millerlp/MusselGapeTracker/(commit log)

2017-06-19 NON-FUNCTIONAL
    Hardware needs revision since ADC7 can't be used as an output to control
    the battery monitor circuit.
2017-06-20 Working 16-channel polling of the hall effect sensors
2017-06-21 Fixing name in comments
    [Shift_mux_test2.ino]
2017-06-21 Basic functionality - datalogging and singel-channel live update
    Currently begins auto-logging to SD card on all 16 channels. Also
    implemented a setup mode (hold button1 for 3 seconds) to show fast
    updates of a single channel. Need to implement a screen power-off and
    channel selection during normal datalogging.
2017-06-22 Added screen updates and timeout
    Still tracking down a bug that causes a hang intermittenly. Have tried
    implementing a watchdog timer (2sec) to see if that at least gets the
    reset working, but it's still not clear where the hang is coming from. The
    real time clock continues running and outputting 32.768kHz signal, so it's
    not an issue with the power supply. Button2 is currently co-opted as an
    output in this version to help with monitoring on the scope ( bitSet(PIND,
    3) peppered throughout)
    [Logger_test.ino]
2017-06-22 Added watchdog timer reset to try to bandaid fix the occasional hangups. I believe the occasional hangs were due to the I2C bus freezing, which can supposedly lock the entire AVR and require a full r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
    [Logger_test.ino]
2017-06-22 Enabling watchdog and switching to Optiboot v6.2 so that I can check the MCUSR register after a reboot to know why it rebooted. The system appears to be generating a large current draw for approx 1 s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
    [Logger_test.ino]
2017-06-23 Switching off some of the LED flashing
2017-06-23 Adding comments for correct bootloader
    [Logger_test.ino]
2017-06-25 Adding flag to declare full OLED screen redraws
    Set screenChange = true to force the OLED screen to redraw the channel
    labels, or false to only update the Hall effect values (faster).
    Interestingly, the optiboot bootloader appears to be jumping to the main
    program too fast for my home ftdi programmer, so I have to hit the reset
    button just prior to attempting a new firmware upload over serial.
    [Logger_test.ino]
2017-06-25 Implementing current filename display
    User can press Button 1 to cycle through the channels on display, and
    eventually get to a 5th screen that just shows the current file name.
2017-06-26 Testing current draw
2017-06-26 Experimenting with only taking readings on save interval
    Test case where Hall sensors are only read when the takeSamples flag is
    true and either the OLED screen is on or the writeData flag is true.
    This has introduced a symptom where the current draw is not returning to
    normal after a SD write until another round of Hall sensor readings are
    taken.
2017-06-27 Adding delay + shift register clear after writeToSD
    Was having a problem with high current draw immediately after writes to
    the SD card. It appears the shift register (which shares the SPI bus
    with the SD card) wasn't happy with whatever signals were being sent to
    the SD card and was occasionally ending up in some kind of high current
    draw state. Adding a 10ms delay and an additional clear() call to the
    shift registers after the writeToSD call appears to have removed the
    high current draw issue.
    [Logger_test.ino, MusselGapeTracker.ino]
2018-09-07 Adding boards.txt entry
2018-09-27 Changing ouptut to input Button2
    Button 2 isn't currently used for any functions, but I might as well make it a functional input for the future.
2018-10-18 Fixing RevC pin assignments
    Switched analog input from A0 to A7 to suit RevC hardware.
    [MusselGapeTracker.ino]
2018-10-25 Quick test sketch to see that ADC6 works
    Written for older RevA hardware, but should work on RevC hardware as well, if you enable the battery monitor line BATT_MONITOR_EN.
2018-10-25 Removing testing pin twiddling
2018-11-28 Checking on calibration mode, needs work
    Need to update and include calibration output here, chase down why analog data isn't showing up on screen
2019-04-30 Fixed calibration mode readout
    Needed to enable the multiplexer in the calibration mode in order to show the Hall sensor readout for the single channel.
    [MusselGapeTracker.ino]
2019-04-30 Built two more boards
2019-05-01 Working routine, needs refinement
    Functional prototype, can be used to choose 1 of 16 Hall effect channels and write calibration data to SD card. Could use some refinement on the OLED screen display.
2019-05-02 Revising instructions, OLED updates
    Functional program now, can be used to calibrate Hall effect sensors.
2019-05-03 Fixed filename channel numbering
    [Hall_tester_MusselGapeTracker_RevC.ino]
2019-05-06 Fixing a strange hang
    This flash wasn't needed anyhow.
    [Hall_tester_MusselGapeTracker_RevC.ino]
2019-05-15 Functional battery monitor
    The RevC silkscreen was originally wrong, R30 shoudl be 15k ohm, and R29 should be 10k, in which case this test sketch then correctly reports battery voltage.
    [Battery_voltage_check.ino]
2019-05-16 Implementing battery voltage check
    TEST ME. See that correct battery voltage is read out on the last status display screen on the OLED screen (the one that shows file name and save interval)
    [MusselGapeTracker.ino]
2019-05-16 Adding battery voltage to output files
    Also marked update to Revision D hardware. This software is compatible with both Revisions C and D.
2019-11-26 Testing responsiveness
    Running at SPS == 16 Hz instead of 4 Hz.
2019-11-26 Trying to track down hang cause
    The device is occasionally reseting, possibly due to watchdog timeout, for unknown reasons. Somethings this happens within 1 minute of a reboot. In other cases, the device appears to hang with the green LED flashing quickly, permanently. Changed reboot flash from green to red to see if that is the source of the permanent green-flash hang.
    [MusselGapeTracker.ino]
2019-11-26 Still tracking hang
    Removed checkMCUSR function just in case, though I doubt it's a cause. Extended/slowed the flash time on the reboot notification (using REDLED)
    [MusselGapeTracker.ino]
2019-11-26 Revert "Still tracking hang"
    This reverts commit 5d014742e94ebe63f66de097fdd4aeeccc529d5c.
    [MusselGapeTracker.ino]
2019-11-26 Revert "Trying to track down hang cause"
    This reverts commit 9afe90cb765e7c3774195083e6148866cc23a96f.
    [MusselGapeTracker.ino]
2019-11-26 Revert "Testing responsiveness"
    This reverts commit a36882fecc82b7194d7f228fae6689284d06532c.
    [MusselGapeTracker.ino]
2019-11-26 Revert "Extending timeout, showing time on screen"
    This reverts commit 02917d3a670c2e9eb0d1ec4ffc5d7a0879219c41.
    [MusselGapeTracker.ino]
2019-11-26 Revert "Adding time value to status screen"
    This reverts commit 3342cc8b54f564656a730ff7ee773776ce62970a.
    [MusselGapeTracker.ino]
2019-11-26 Debugging: SPI half speed, toggle D3 at sd write
    Reboot LED is now RED. Switching BUTTON2 to an output, to use the bitSet() function around the writetoSD function for monitoring on the o-scope. Also added 10uF cap to the RevC SN22 board I'm testing on.
    [MusselGapeTracker.ino]
2019-11-27 Pulling BUTTON2 low initially
    Testing this version that hopefully cures random reboots and hangs.
    [MusselGapeTracker.ino]
2019-11-27 Updating I2C speed setting
    Removing deprecated I2C speed setting, moving oled initialization down below Wire.begin(), setting SD card back to full speed for testing.
2019-12-02 Working on resposiveness of button press
    Still needs work to wake up in a reasonable amount of time from having the screen off.
2020-01-23 Fixing button1 responsiveness issue
    Actually needed a slight delay during the debounce routine to effectively register the debounce delay was successful.
    [MusselGapeTracker.ino]
2020-03-03 Copy of the instructions
    For using the syringe pump for calibrations, updated with newer Diameter + Volume settings
2021-03-12 Moving programs to main folder
    Created new boards SN26,27,28 serial numbers today 2021-03-11
2021-07-23 Assembled 3 new boards RevE
2022-06-08 Board image
2022-06-08 Adding board image to readme
2023-02-02 Creating a test program using old Rev A hardware
    This is only going to work on an old Rev A board that was laying around.
2023-02-02 LED flashing scales approximately with signal strength
2023-03-01 Quick check program for new sensor leads
2023-03-01 Updated for UW build, six new boards RevF
2023-04-14 Updating for Rev C/E etc boards
2023-04-14 First cut, needs testing
2023-04-17 Switching to send uint16_t instead of float
    Only sends 1 gape channel
